minisystem/881/README.md

SYSTEM80 881
======================================

Trigger expander module for 880

Hardware design by Minisystem: info@system80.net

LICENSE
=======
cc by-nc-sa
https://creativecommons.org/licenses/by-nc-sa/4.0/
