minisystem/881/881_back_panel-brd.png

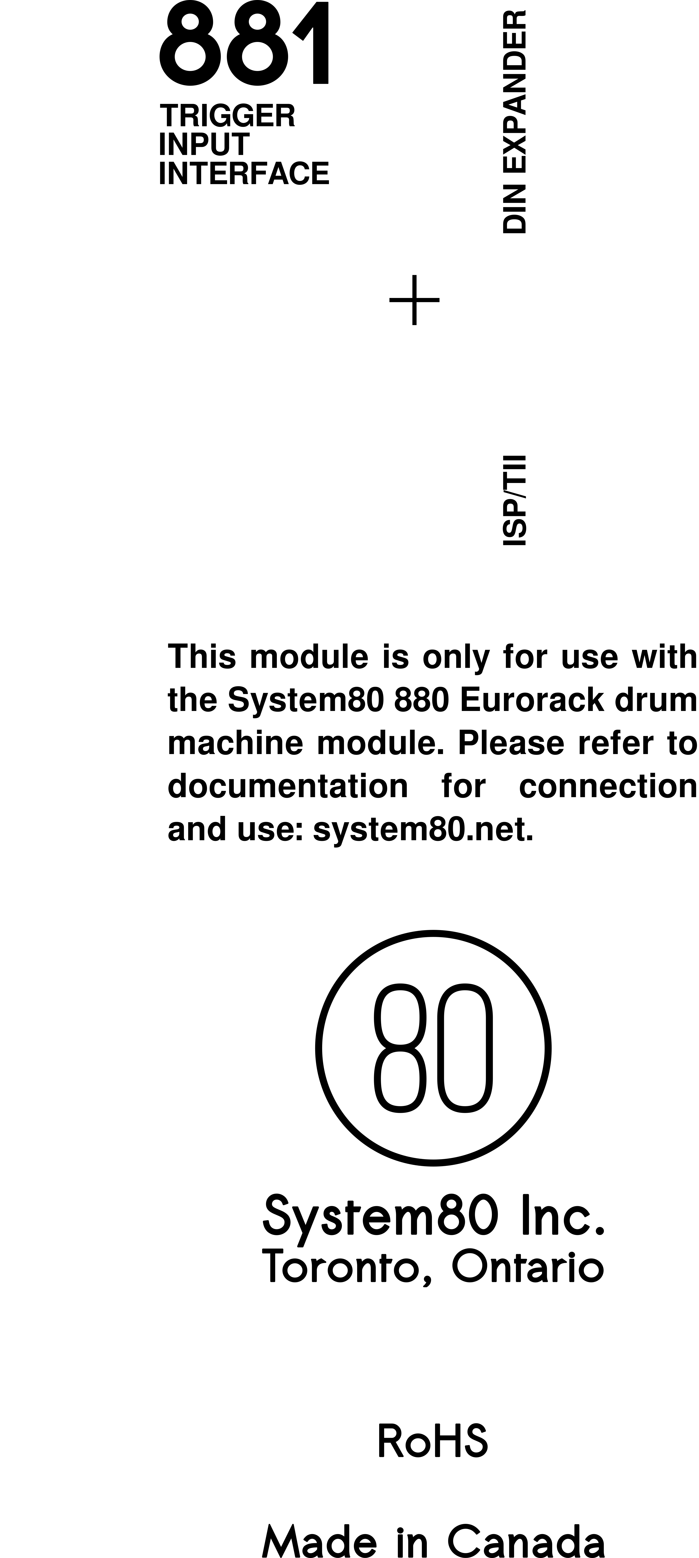
881_back_panel-brd.png
