minisystem/881/bom.xls

Comment | Designator | Footprint | JLCPCB Part #
74AHCT1G125GW | U7 | SOT-353_SC-70-5 | C12495
1n | C4 | 603 | C1588
220R | R1,R3 | SM0603-R-YAGEO | C22962
100K | R6,R7,R8,R9,R10,R11,R12,R13,R18,R19,R20,R21,R22,R23,R24,R25,R30,R31,R32,R33,R34,R35,R36,R37,R46 | SM0603-R-YAGEO | C25803
B5819W | D1,D2,D3,D4 | D_SOD-123 | C8598
47K | R42,R43,R44 | SM0603-R-YAGEO | C25819
0.01μ | C1 | 603 | C57112
74HC165 | U1,U2 | SOIC-16_3.9x9.9mm_Pitch1.27mm | C5613
1μ | C15 | 805 | C28323
0.1μ | C2,C3,C19,C20 | 603 | C14663
MMBT3906 | Q14 | SOT-23 | C2143
22R | R2 | SM0603-R-YAGEO | C23345
1K | R4,R5 | SM0603-R-YAGEO | C21190
10K | R14,R15,R16,R17,R26,R27,R28,R29,R38,R39,R40,R41 | SM0603-R-YAGEO | C25804
2K7 | R49 | SM0603-R-YAGEO | C13167
1N4148 | D5,D16,D15,D14,D13,D12,D11,D10,D9,D8,D7,D6 | D_SOD-323F | C2128
MMBT3904 | Q1,Q2,Q3,Q4,Q5,Q6,Q7,Q8,Q9,Q10,Q11,Q12 | SOT23-132-JRL | C20526
