minisystem/881/Gerbers/881-Dwgs.User.dxf

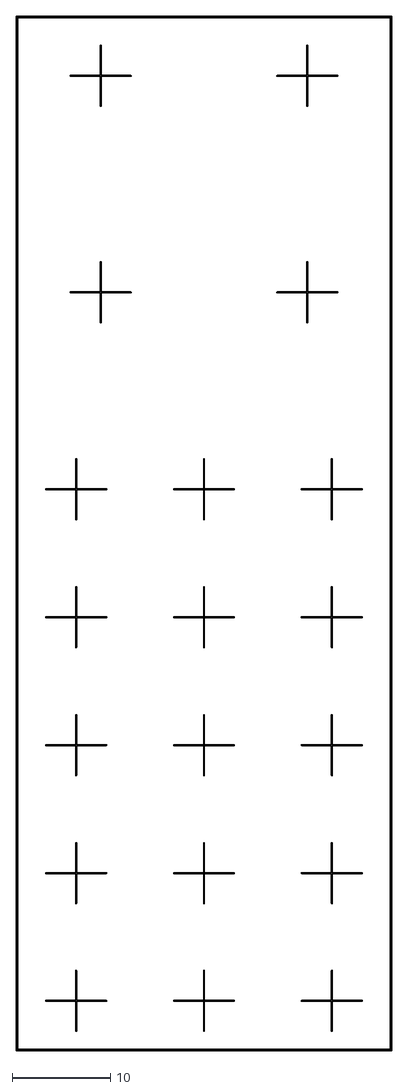
[picture p2: CAD file, 2024-04-17]
Gerbers/881-Dwgs.User.dxf
38.1 x 105.1
