minisystem/881/hole_centres.dxf

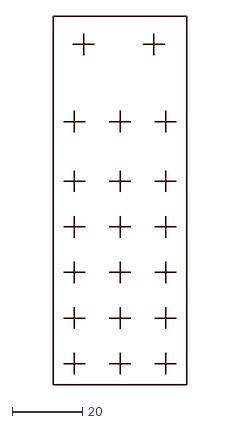
[picture p3: CAD file, 2024-04-17]
hole_centres.dxf
38.0 x 105.0
