minisystem/881/panel/881_panel_mechanical.dxf

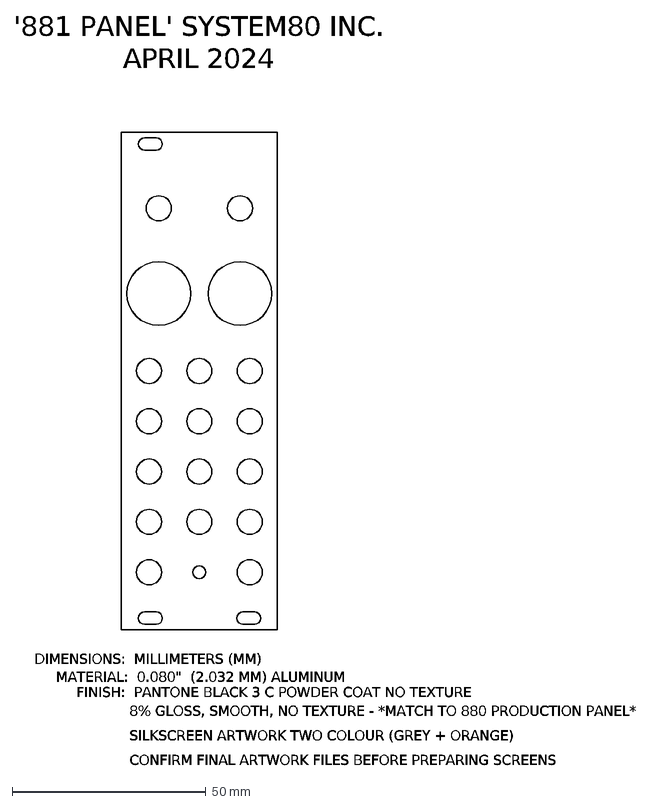
[picture p4: CAD file, 2024-04-22]
panel/881_panel_mechanical.dxf
8% GLOSS, SMOOTH, NO TEXTURE - *MATCH TO 880 PRODUCTION PANEL* SILKSCREEN ARTWORK TWO COLOUR (GREY + ORANGE) CONFIRM FINAL ARTWORK FILES BEFORE PREPARING SCREEN
DIMENSIONS: MILLIMETERS (MM)
MATERIAL: 0.080" (2.032 MM) ALUMINUM
FINISH: PANTONE BLACK 3 C POWDER COAT NO TEXTURE
'881 PANEL' SYSTEM80 INC. APRIL 2024
