minisystem/881/panel/881_panel_mechanical.pdf

# '881 PANEL' SYSTEM80 INC. APRIL 2024

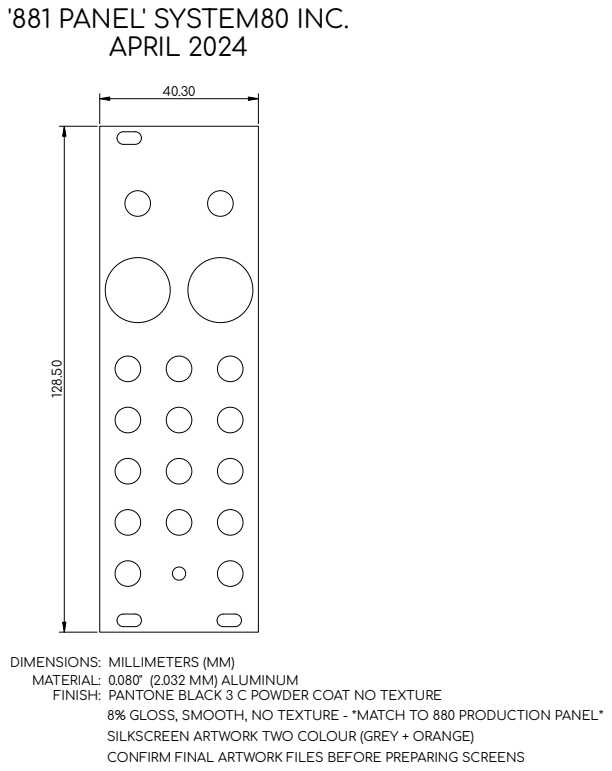
[picture p5: page 1]

DIMENSIONS: MILLIMETERS (MM)
MATERIAL: 0.080" (2.032 MM) ALUMINUM
FINISH: PANTONE BLACK 3 C POWDER COAT NO TEXTURE

8% GLOSS, SMOOTH, NO TEXTURE - *MATCH TO 880 PRODUCTION PANEL* SILKSCREEN ARTWORK TWO COLOUR (GREY + ORANGE)

CONFIRM FINAL ARTWORK FILES BEFORE PREPARING SCREENS
