minisystem/881/panel/881_panel_overview.pdf

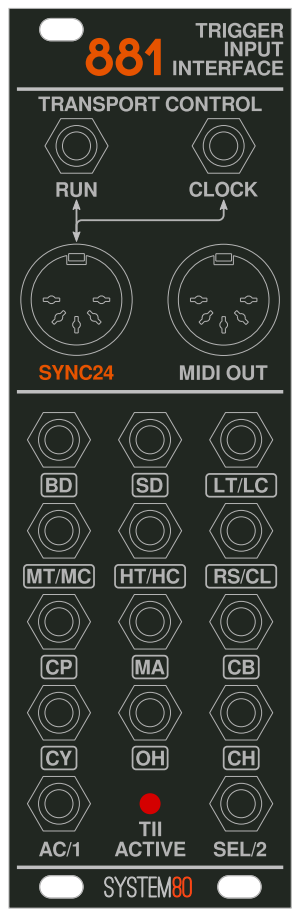
[picture p6: page 1]
