minisystem/881/Gerbers/881-Dwgs.User.pdf

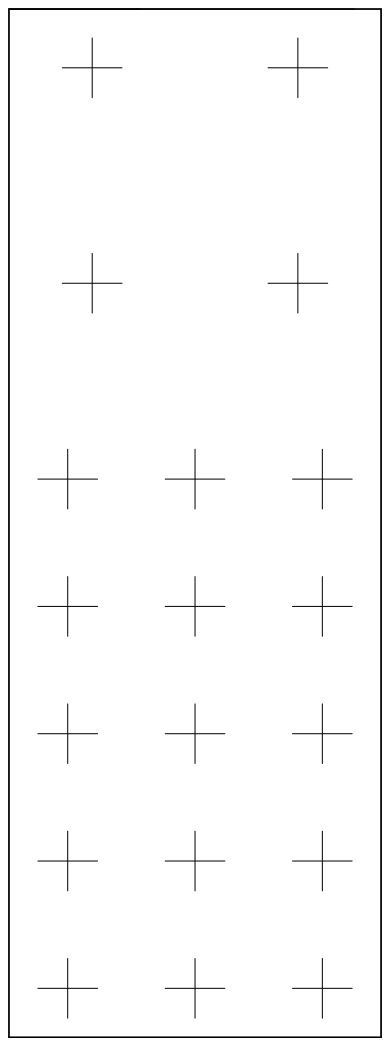
[picture p7: page 1]
