minisystem/881/panel/881_artwork_grey.pdf

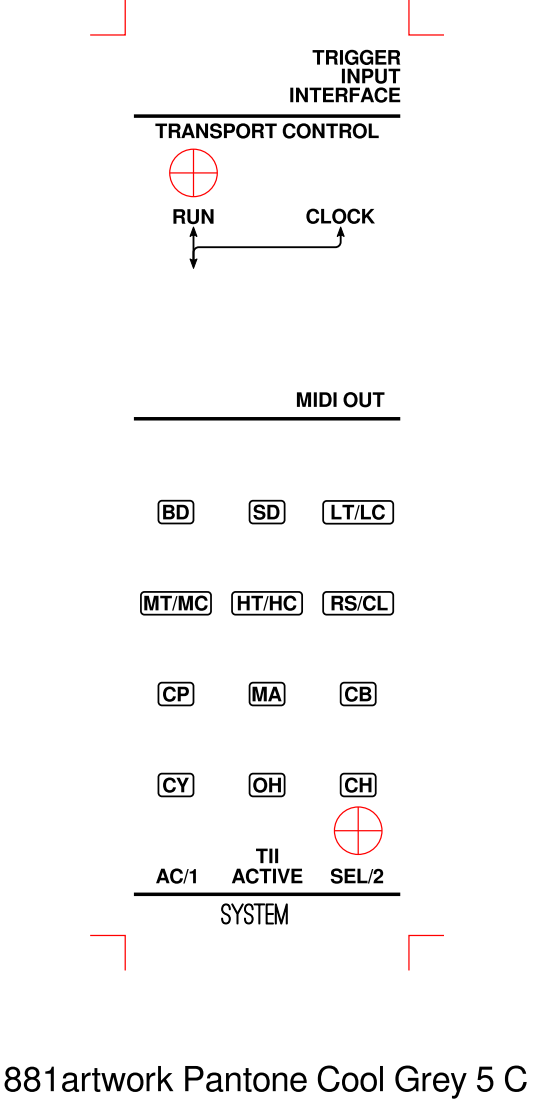
[picture p8: page 1]
