minisystem/881/panel/881_artwork_orange.pdf

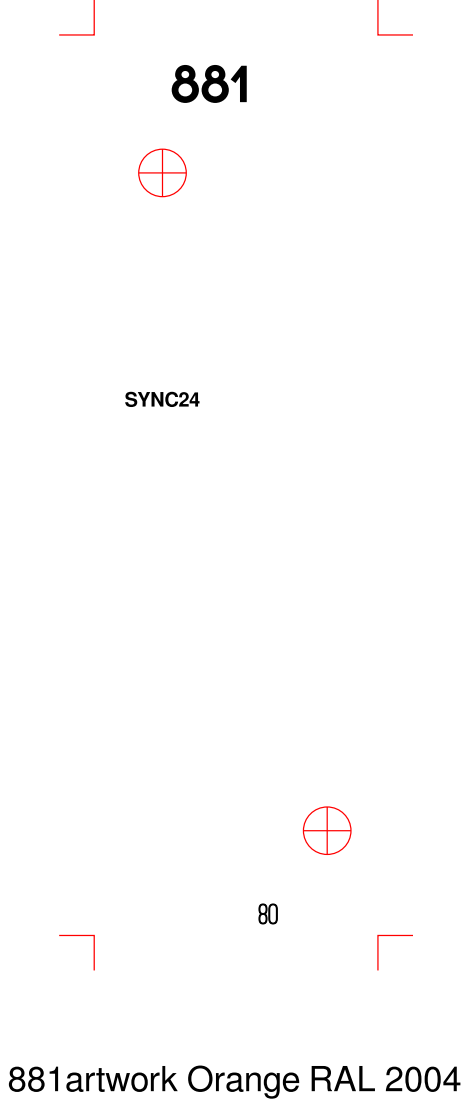
[picture p9: page 1]
