minisystem/881/881.kicad_pcb

## KiCad design 881.kicad_pcb (2024-04-17)

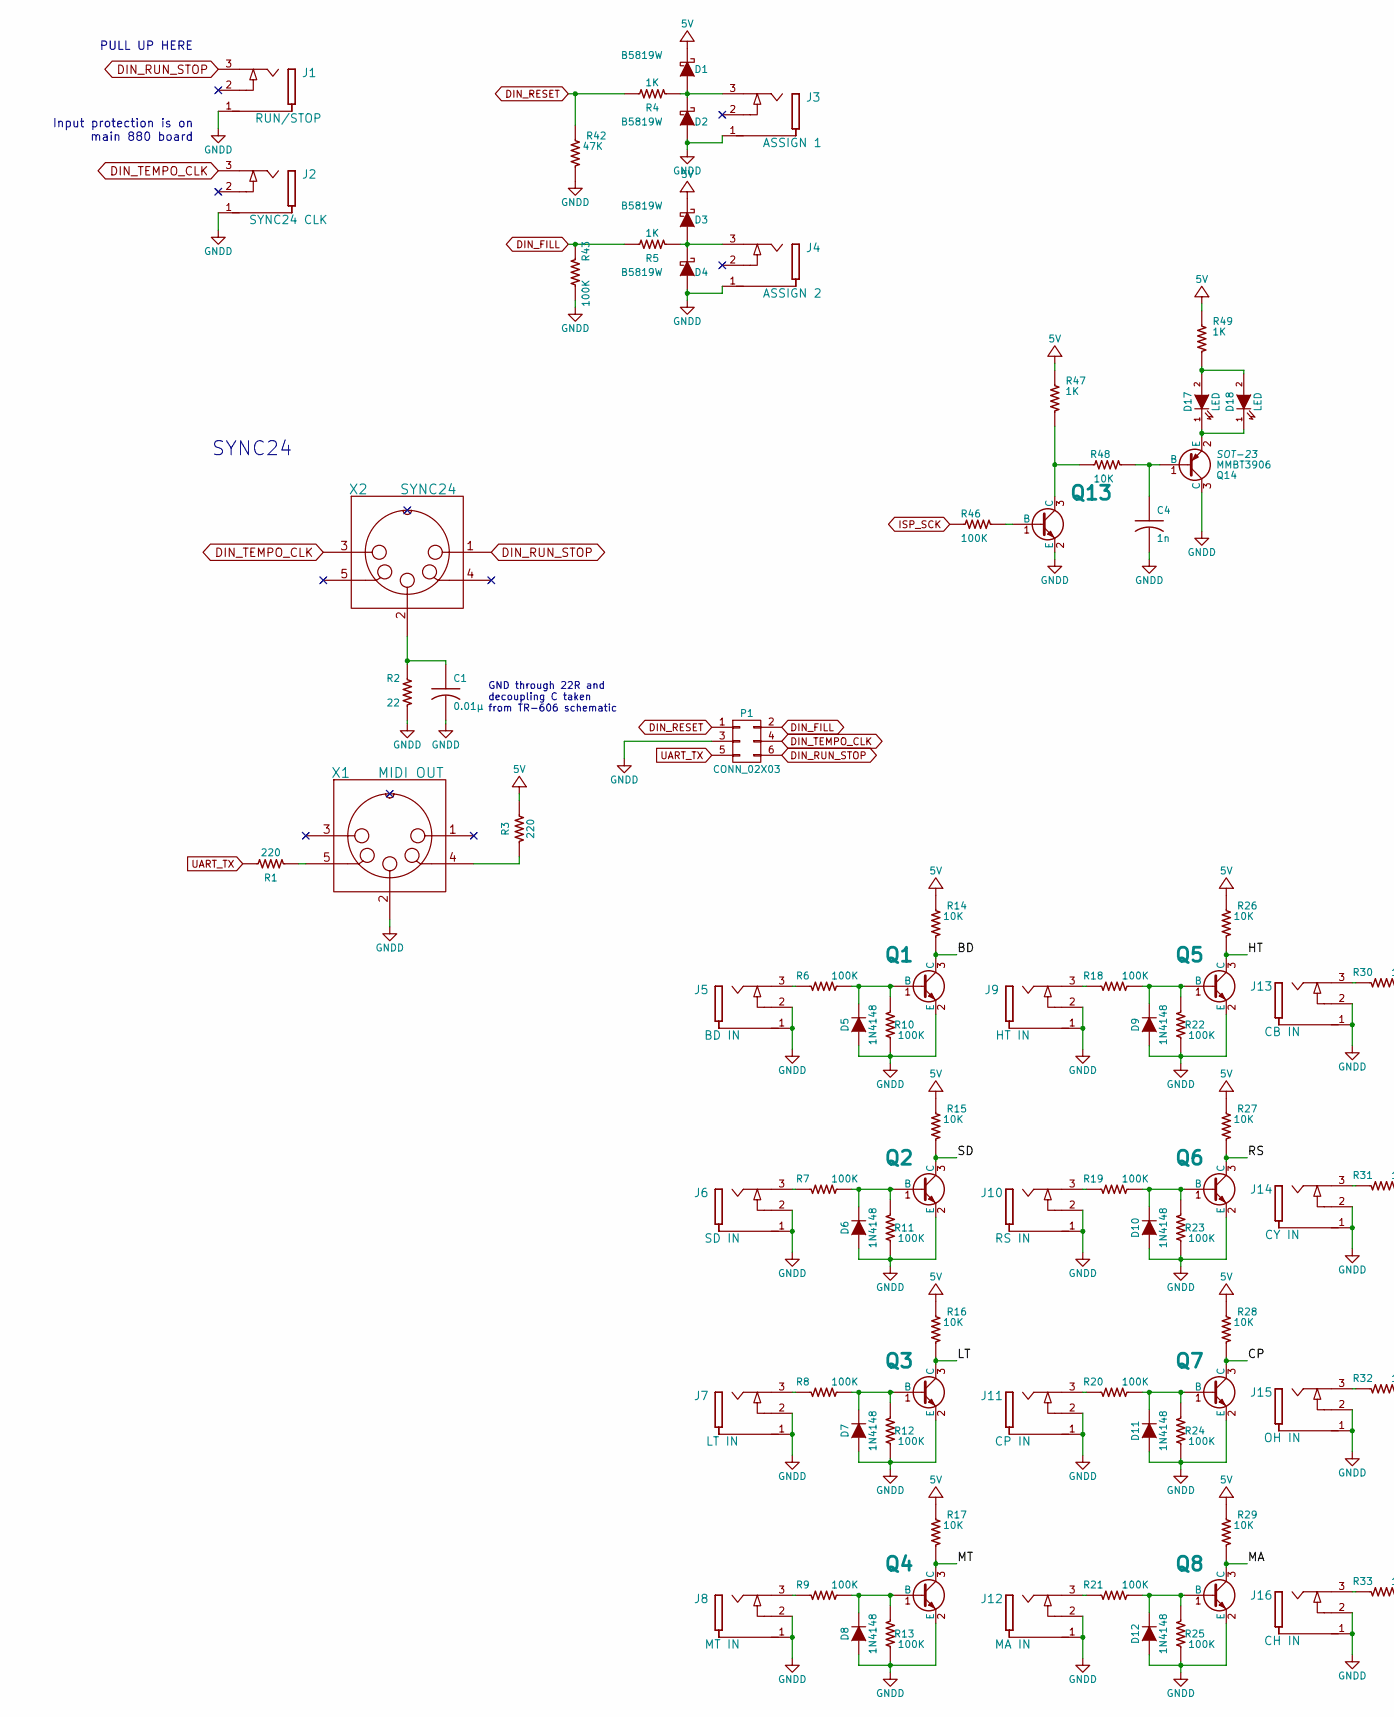
[picture p10: schematic 881.sch, part in row 1, column 1]

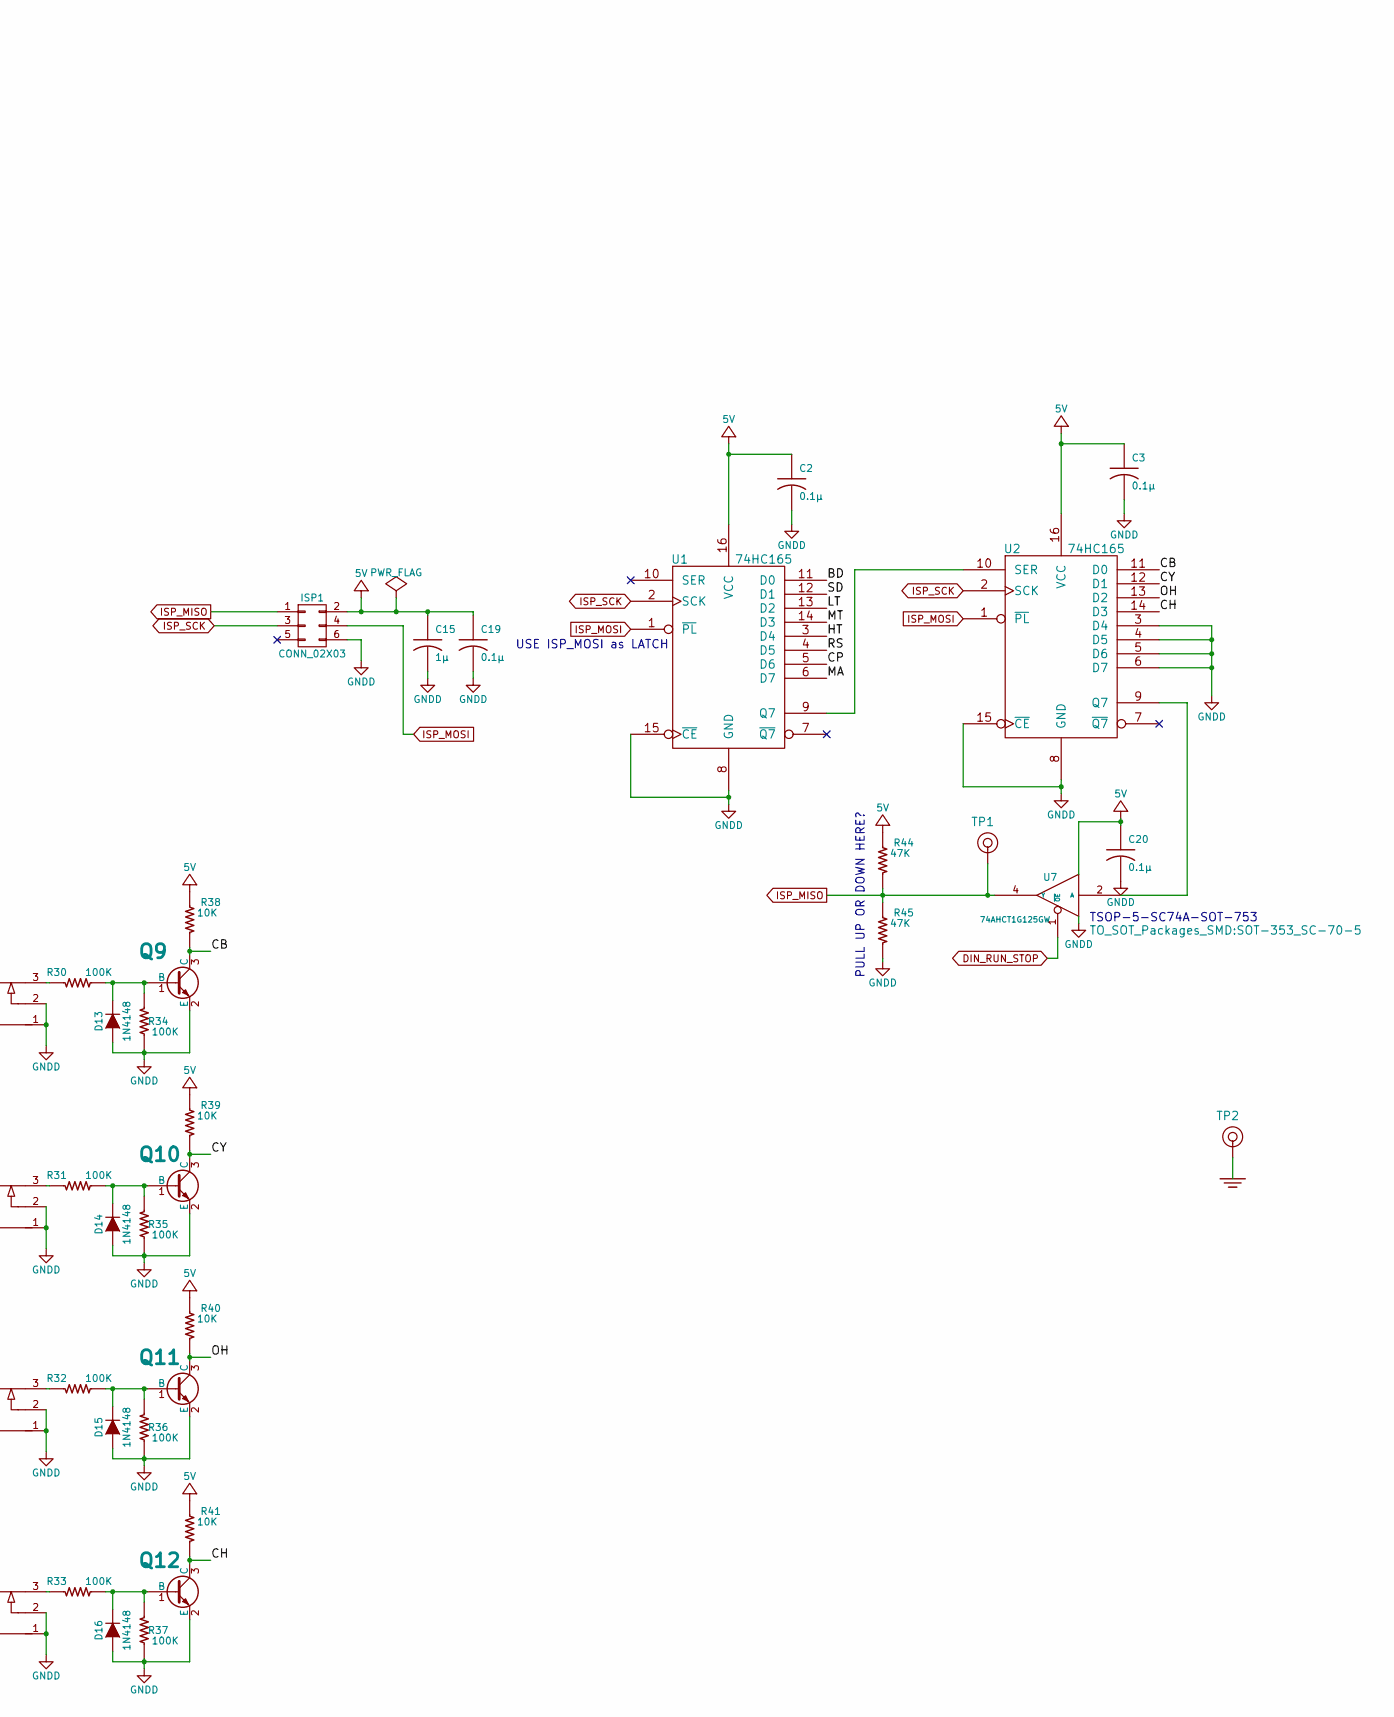
[picture p11: schematic 881.sch, part in row 1, column 2]

Parts:
C1: 0.01µ; SM0603-C-MURATA
C2, C3, C19, C20: 0.1µ; SM0603-C-MURATA
C4: 1n; SM0603-C-MURATA
C15: 1µ; C_0805
D1: B5819W; D_SOD-123; JLC C8598
D2, D3, D4: B5819W; D_SOD-123
D5: 1N4148; D_SOD-323F; JLC C2128
D6, D7, D8, D9, D10, D11, D12, D13, D14, D15, D16: 1N4148; SOD323-C1A2
D17: LED; LED_0805; JLC C84256
D18: LED; LED_D3.0mm
ISP1: CONN_02X03; vasch_strip_3x2
J1: RUN/STOP; PJ-301B-JACK-SLOTS
J2: SYNC24 CLK; PJ-301B-JACK-SLOTS
J3: ASSIGN 1; PJ-301B-JACK-SLOTS
J4: ASSIGN 2; PJ-301B-JACK-SLOTS
J5: BD IN; PJ-301B-JACK-SLOTS
J6: SD IN; PJ-301B-JACK-SLOTS
J7: LT IN; PJ-301B-JACK-SLOTS
J8: MT IN; PJ-301B-JACK-SLOTS
J9: HT IN; PJ-301B-JACK-SLOTS
J10: RS IN; PJ-301B-JACK-SLOTS
J11: CP IN; PJ-301B-JACK-SLOTS
J12: MA IN; PJ-301B-JACK-SLOTS
J13: CB IN; PJ-301B-JACK-SLOTS
J14: CY IN; PJ-301B-JACK-SLOTS
J15: OH IN; PJ-301B-JACK-SLOTS
J16: CH IN; PJ-301B-JACK-SLOTS
P1: CONN_02X03; vasch_strip_4x2
Q1, Q2, Q3, Q4, Q5, Q6, Q7, Q8, Q9, Q10, Q11, Q12, Q13: MMBT3904; SOT23-132-JRL
Q14: MMBT3906; SOT-23
R1, R3: 220; SM0603-R-YAGEO
R2: 22; SM0603-R-YAGEO
R4, R5, R47, R49: 1K; SM0603-R-YAGEO
R6, R7, R8, R9, R10, R11, R12, R13, R18, R19, R20, R21, R22, R23, R24, R25, R30, R31, R32, R33, R34, R35, R36, R37, R43, R46: 100K; SM0603-R-YAGEO
R14, R15, R16, R17, R26, R27, R28, R29, R38, R39, R40, R41, R48: 10K; SM0603-R-YAGEO
R42, R44, R45: 47K; SM0603-R-YAGEO
TP1, TP2: CONN_1; TEST_POINT_LOOP_4592
U1, U2: 74HC165; SOIC-16_3.9x9.9mm_Pitch1.27mm; JLC C5613
U7: 74AHCT1G125GW; SOT-353_SC-70-5; JLC C12495
X1: MIDI OUT; SD-50BV-5DIN
X2: SYNC24; SD-50BV-5DIN

Connections:
+5V: C2.1, C3.1, C15.1, C19.1, C20.1, D1.1 (K), D3.1 (K), ISP1.2, R3.2, R14.1, R15.1, R16.1, R17.1, R26.1, R27.1, R28.1, R29.1, R38.1, R39.1, R40.1, R41.1, R44.1, R47.1, R49.1, U1.16 (VCC), U2.16 (VCC), U7.5 (VCC)
/BD: Q1.3 (C), R14.2, U1.11 (D0)
/CB: Q9.3 (C), R38.2, U2.11 (D0)
/CH: Q12.3 (C), R41.2, U2.14 (D3)
/CP: Q7.3 (C), R28.2, U1.5 (D6)
/CY: Q10.3 (C), R39.2, U2.12 (D1)
/HT: Q5.3 (C), R26.2, U1.3 (D4)
/LT: Q3.3 (C), R16.2, U1.13 (D2)
/MA: Q8.3 (C), R29.2, U1.6 (D7)
/MT: Q4.3 (C), R17.2, U1.14 (D3)
/OH: Q11.3 (C), R40.2, U2.13 (D2)
/RS: Q6.3 (C), R27.2, U1.4 (D5)
/SD: Q2.3 (C), R15.2, U1.12 (D1)
DIN_FILL: P1.2, R5.2, R43.1
DIN_RESET: P1.1, R4.2, R42.1
DIN_RUN_STOP: J1.3, P1.6, U7.1 (~OE), X2.1
DIN_TEMPO_CLK: J2.3, P1.4, X2.3
GNDD: C1.2, C2.2, C3.2, C4.2, C15.2, C19.2, C20.2, D2.2 (A), D4.2 (A), D5.2 (A), D6.2 (A), D7.2 (A), D8.2 (A), D9.2 (A), D10.2 (A), D11.2 (A), D12.2 (A), D13.2 (A), D14.2 (A), D15.2 (A), D16.2 (A), ISP1.6, J1.1, J2.1, J3.1, J4.1, J5.1, J5.2, J6.1, J6.2, J7.1, J7.2, J8.1, J8.2, J9.1, J9.2, J10.1, J10.2, J11.1, J11.2, J12.1, J12.2, J13.1, J13.2, J14.1, J14.2, J15.1, J15.2, J16.1, J16.2, P1.3, Q1.2 (E), Q2.2 (E), Q3.2 (E), Q4.2 (E), Q5.2 (E), Q6.2 (E), Q7.2 (E), Q8.2 (E), Q9.2 (E), Q10.2 (E), Q11.2 (E), Q12.2 (E), Q13.2 (E), Q14.3 (C), R2.1, R10.2, R11.2, R12.2, R13.2, R22.2, R23.2, R24.2, R25.2, R34.2, R35.2, R36.2, R37.2, R42.2, R43.2, R45.2, U1.8 (GND), U1.15 (~CE), U2.3 (D4), U2.4 (D5), U2.5 (D6), U2.6 (D7), U2.8 (GND), U2.15 (~CE), U7.3 (GNDD), X1.2
ISP_MISO: ISP1.1, R44.2, R45.1, TP1.1, U7.4 (Y)
ISP_MOSI: ISP1.4, U1.1 (~PL), U2.1 (~PL)
ISP_SCK: ISP1.3, R46.2, U1.2 (SCK), U2.2 (SCK)
unnamed: C1.1, R2.2, X2.2
unnamed: D1.2 (A), D2.1 (K), J3.3, R4.1
unnamed: D3.2 (A), D4.1 (K), J4.3, R5.1
unnamed: D5.1 (K), Q1.1 (B), R6.2, R10.1
unnamed: D6.1 (K), Q2.1 (B), R7.2, R11.1
unnamed: D7.1 (K), Q3.1 (B), R8.2, R12.1
unnamed: D8.1 (K), Q4.1 (B), R9.2, R13.1
unnamed: D9.1 (K), Q5.1 (B), R18.2, R22.1
unnamed: D10.1 (K), Q6.1 (B), R19.2, R23.1
unnamed: D11.1 (K), Q7.1 (B), R20.2, R24.1
unnamed: D12.1 (K), Q8.1 (B), R21.2, R25.1
unnamed: D13.1 (K), Q9.1 (B), R30.2, R34.1
unnamed: D14.1 (K), Q10.1 (B), R31.2, R35.1
unnamed: D15.1 (K), Q11.1 (B), R32.2, R36.1
unnamed: D16.1 (K), Q12.1 (B), R33.2, R37.1
unnamed: D17.1 (K), D18.1 (K), Q14.2 (E)
unnamed: D17.2 (A), D18.2 (A), R49.2
unnamed: J5.3, R6.1
unnamed: J6.3, R7.1
unnamed: J7.3, R8.1
unnamed: J8.3, R9.1
unnamed: J9.3, R18.1
unnamed: J10.3, R19.1
unnamed: J11.3, R20.1
unnamed: J12.3, R21.1
unnamed: J13.3, R30.1
unnamed: J14.3, R31.1
unnamed: J15.3, R32.1
unnamed: J16.3, R33.1
unnamed: Q13.3 (C), R47.2, R48.2
unnamed: R1.1, X1.5
unnamed: R3.1, X1.4
unnamed: U1.9 (Q7), U2.10 (SER)
unnamed: U2.9 (Q7), U7.2 (A)
UART_TX: P1.5, R1.2

Notes on the sheet:
SYNC24
GND through 22R and decoupling C taken from TR-606 schematic
USE ISP_MOSI as LATCH
Input protection is on main 880 board
TSOP-5-SC74A-SOT-753
PULL UP OR DOWN HERE?
PULL UP HERE

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
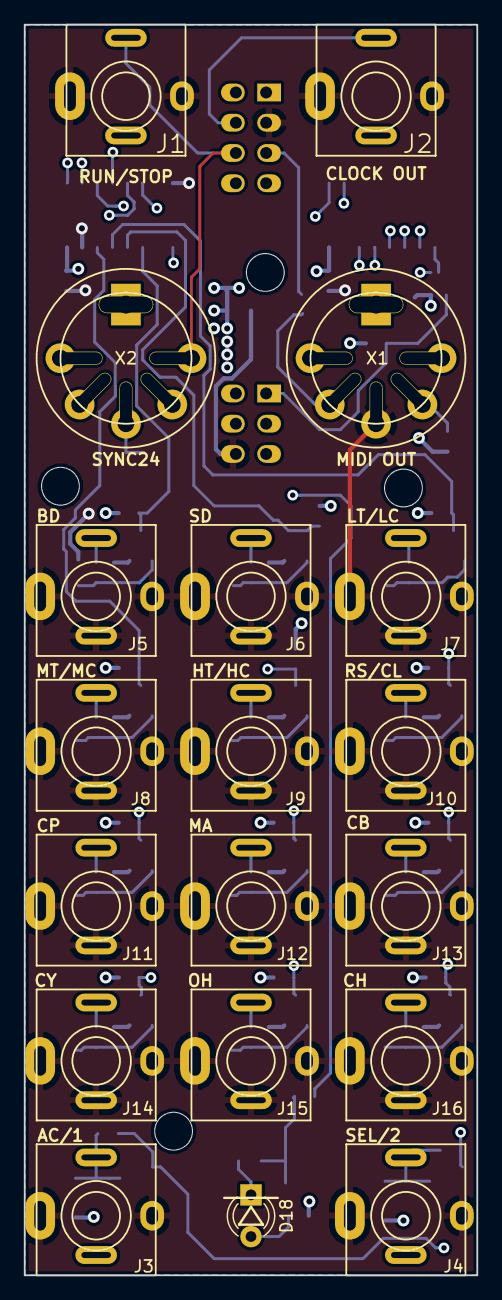
[picture p12: board 881.kicad_pcb from above]

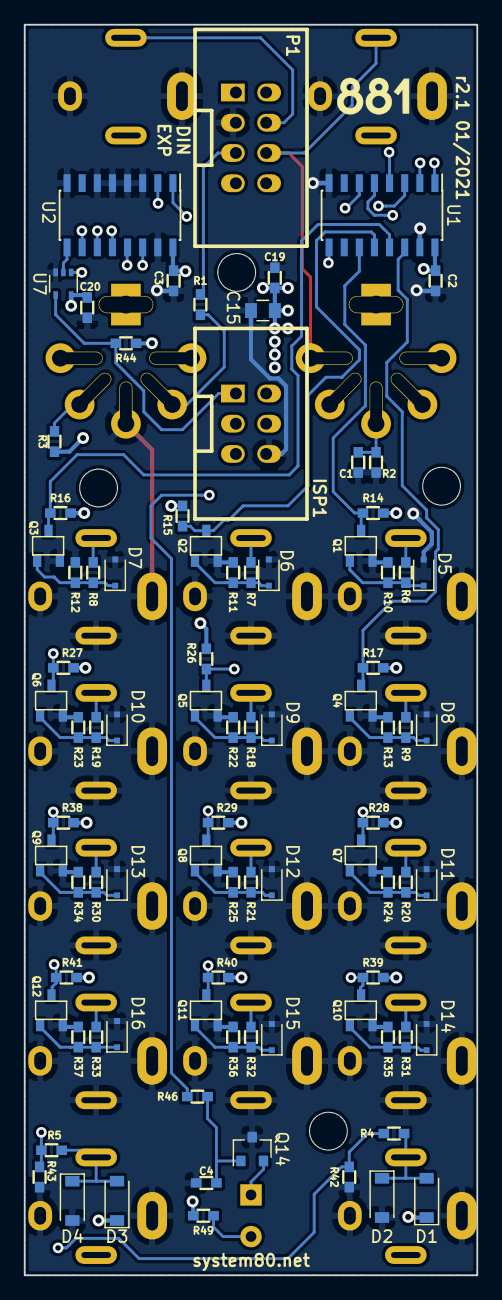
[picture p13: board 881.kicad_pcb from below]

Board: 4 copper layers, 38.0 x 105.0 mm, 110 parts (87 on the bottom side), 56 nets.

Other parts of the board:
SNAP-HOLE-0.125-INCH, SNAP-HOLE-0.125-INCH#2, SNAP-HOLE-0.125-INCH#3, SNAP-HOLE-0.125-INCH#4: VAL**; SNAP_HOLE_0.125_INCH
