minisystem/881/(commit log)

2018-09-23 schematic captured, started layout
    [881.sch, hole_centres.dxf]
2018-09-23 placed and routed
    [881.kicad_pcb, 881.sch]
2018-09-24 ground stitching, tweaking
    [881.kicad_pcb, 881.sch]
2018-10-03 first prototype PCB ordered
    [881-B.Cu.gbl, 881-B.Mask.gbs, 881-B.SilkS.gbo, 881-Edge.Cuts.gm1, 881-F.Cu.gtl, 881-F.Mask.gts, 881-F.SilkS.gto, 881.drl]
2018-11-05 notes added, going to turn this into trigger-MIDI converter
    [881.sch]
2020-09-25 first version of 881, obsolete. next commit will begin with new version for connection to 880 TII and DIN EXP
    [881.sch]
2020-09-26 schematic and footprint almost complete. spi clock or run-stop line for TII active indication still debatable, but leaning towards SPI SCK for LED indication
    [881.kicad_pcb, 881.sch]
2020-09-27 first route
    [881.kicad_pcb, 881.sch]
2020-09-28 routed with more finesse
    [881.kicad_pcb]
2020-09-28 routed, finessed, ready to order me thinks
    [881.kicad_pcb]
2020-09-29 DIN connector had wrong footprint. fixed. need to generate gerbers again before ordering
    [881-bottom.csv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]
2024-04-17 2024 update with panel
    [881-2.1.bottom.xlsx, 881-2022-06-11-15-25-24.sch, 881-2023-12-21-13-57-38.sch, 881-2023-12-23-12-21-13.sch, 881-Dwgs.User.dxf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]
2024-04-22 sent for quoting
    [881_panel_mechanical.dxf]
